KazuKaku/WingFoldingSystem-with-NewGLDAB-PWMout/image/250117 NewGLDAB Action .jpg

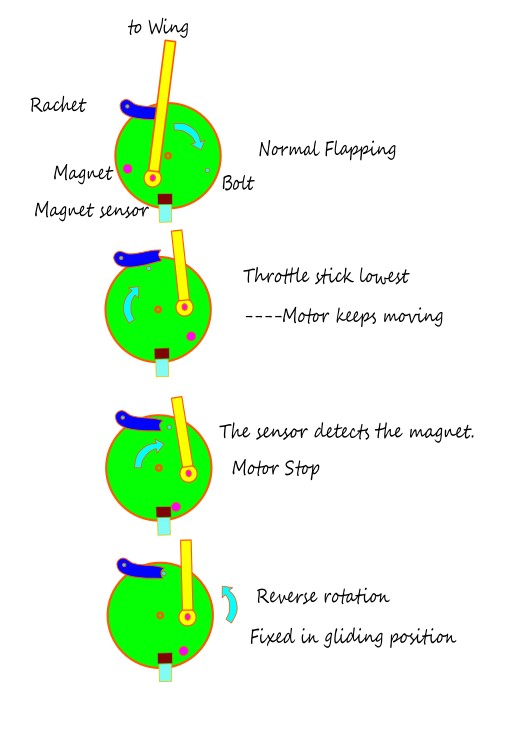
image/250117 NewGLDAB Action .jpg
