KazuKaku/WingFoldingSystem-with-NewGLDAB-PWMout/image/250128 Wing motion .jpg

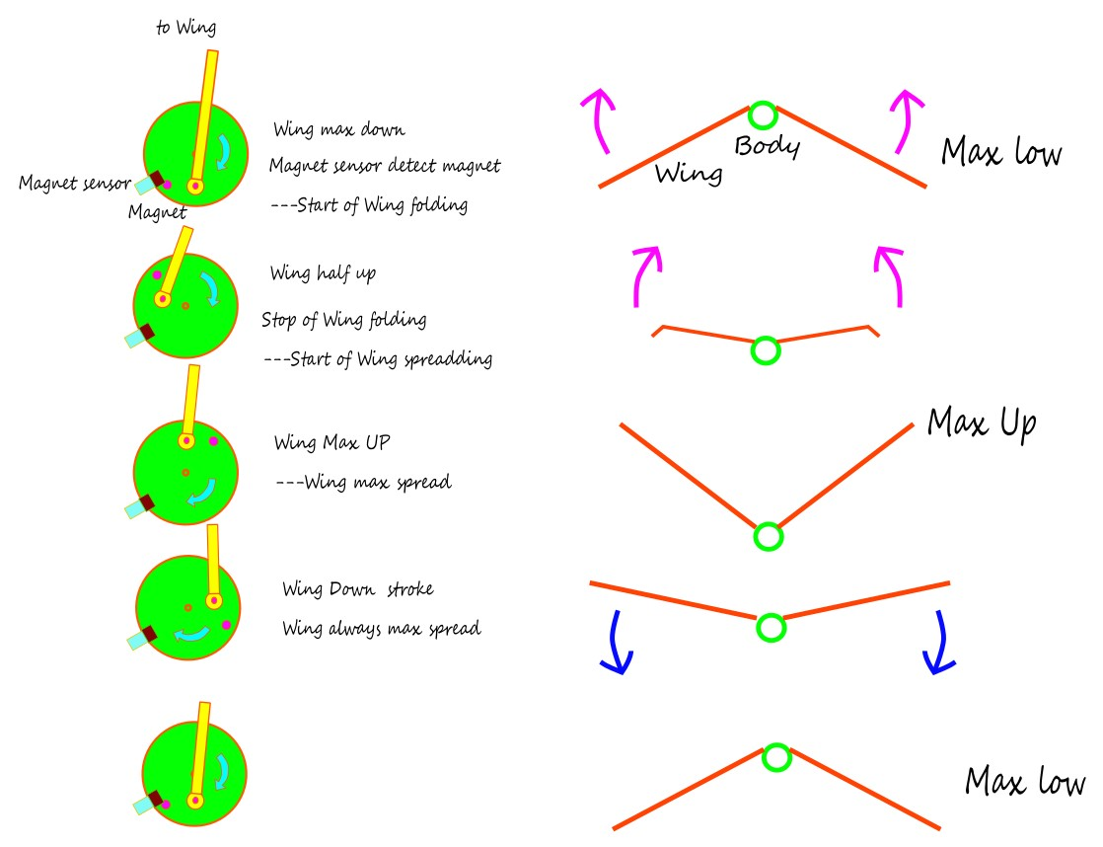
image/250128 Wing motion .jpg
