KazuKaku/WingFoldingSystem-with-NewGLDAB-PWMout/image/250129 onlyFrame  Falcon141 Folding Wing SystemwithAGLDAB.jpg

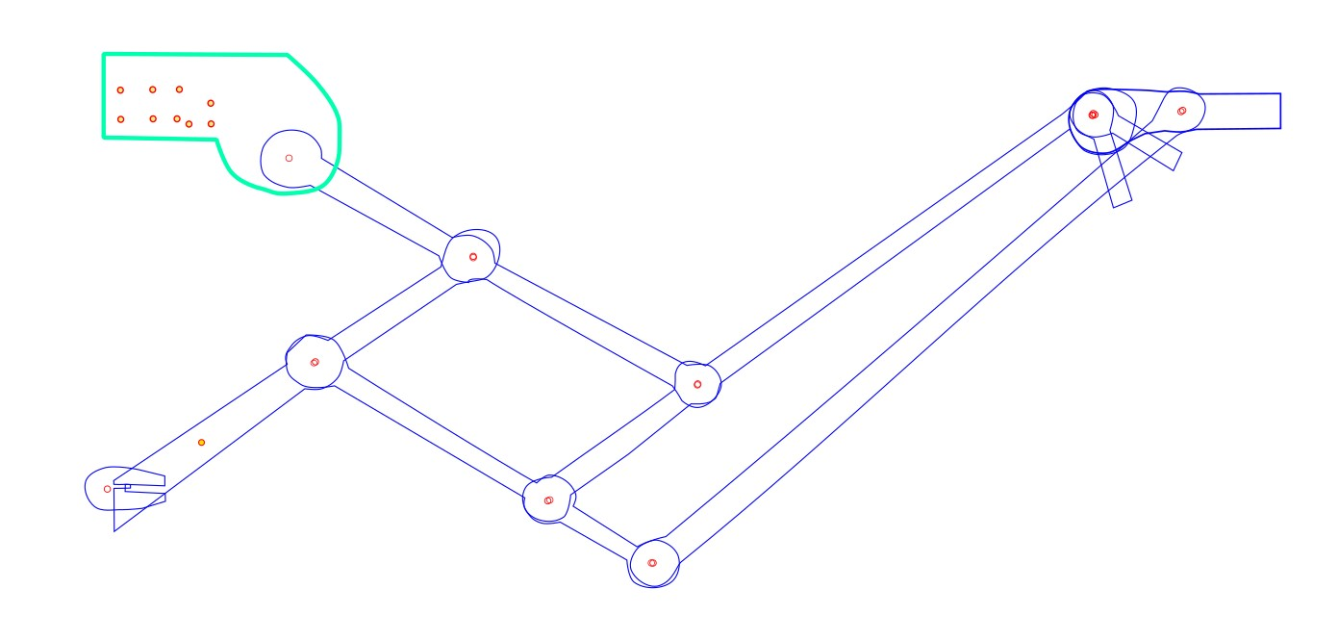
image/250129 onlyFrame Falcon141 Folding Wing SystemwithAGLDAB.jpg
